j-dunc/Mini-Stylophone-V2/docs/images/render_front.png

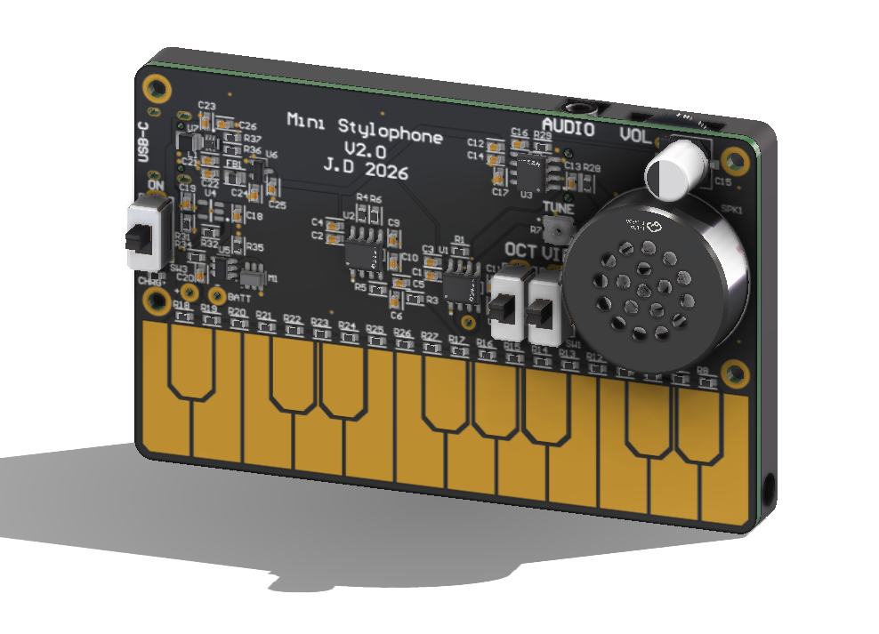
docs/images/render_front.png
