j-dunc/Mini-Stylophone-V2/mechanical/solidworks/top_decal.png

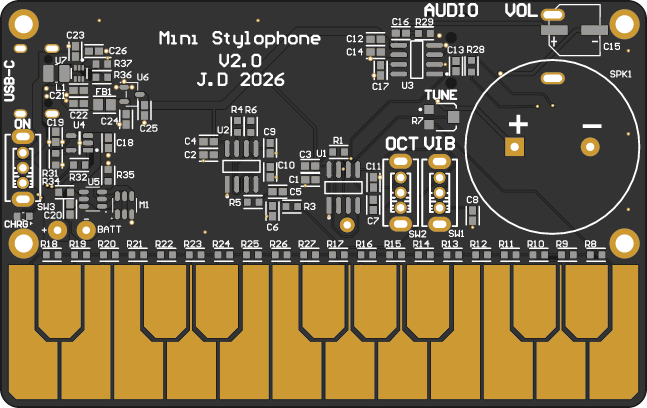
mechanical/solidworks/top_decal.png
