j-dunc/Mini-Stylophone-V2/mechanical/solidworks/StylophonePCB.step

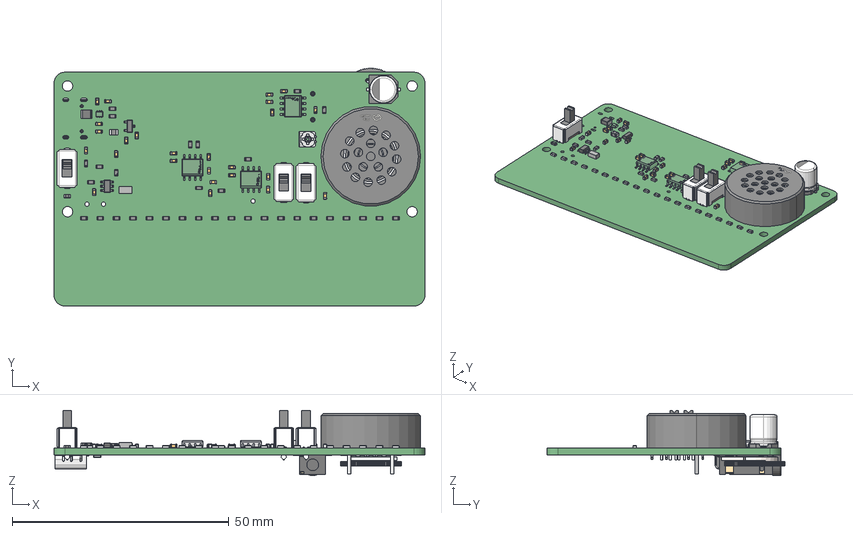
[picture p5: CAD file, 2026-10-17]
mechanical/solidworks/StylophonePCB.step
85.6 x 54.9 x 15.1 mm
USB-C_SMD-TYPE-C-31-M-12_1
name x 25
FRAME-DRL0006A
BODY-SOT
circle x 4
Texas Instruments x 4
Leader x 9
IC_BODY x 3
IC_LEG x 12
IC_LEG_MIR8 x 12
SW-TH_SS12D07VG4 x 3
SPK-TH_BD23.0-P10.00-D0.8-L-RD
Yageo Logo x 35
BOUR-TC33X-2_2
Extruded
Terminal x 2
Mid Body x 2
Electrodes
Dielectric
Murata
CAP-SMD_BD6.3-L6.6-W6.6-FD
RES-SMD_RK10J12R0A0B
AUDIO-SMD_PJ-327A5JJ
