j-dunc/Mini-Stylophone-V2/mechanical/step/Stylus_V1.1.STEP

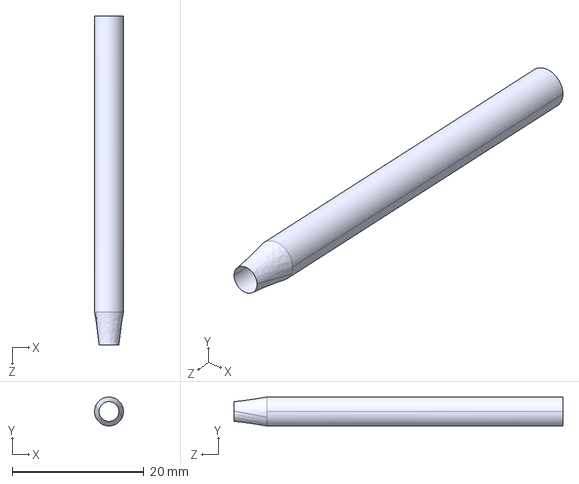
[picture p6: CAD file, 2026-10-17]
mechanical/step/Stylus_V1.1.STEP
4.40 x 4.40 x 50.0 mm
