j-dunc/Mini-Stylophone-V2/mechanical/step/Stylophone_Base_V1.1.STEP

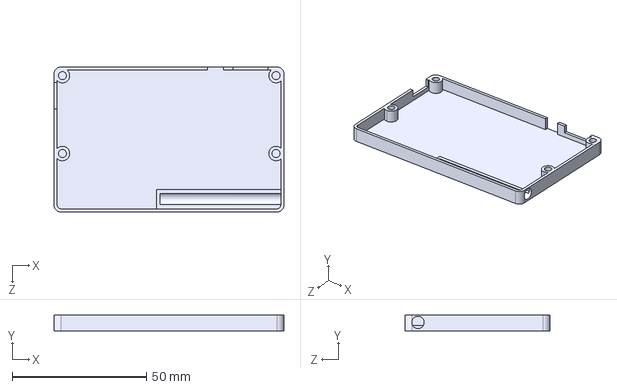
[picture p7: CAD file, 2026-10-17]
mechanical/step/Stylophone_Base_V1.1.STEP
85.6 x 5.80 x 54.0 mm
