j-dunc/Mini-Stylophone-V2/(list of files, cad)

Other CAD files:
mechanical/solidworks/Stylus.SLDPRT
mechanical/solidworks/Stylophone_Base.SLDPRT
mechanical/solidworks/StylophonePCB.SLDASM
