j-dunc/Mini-Stylophone-V2/docs/schematics.pdf

Tone Generator | Vibrato

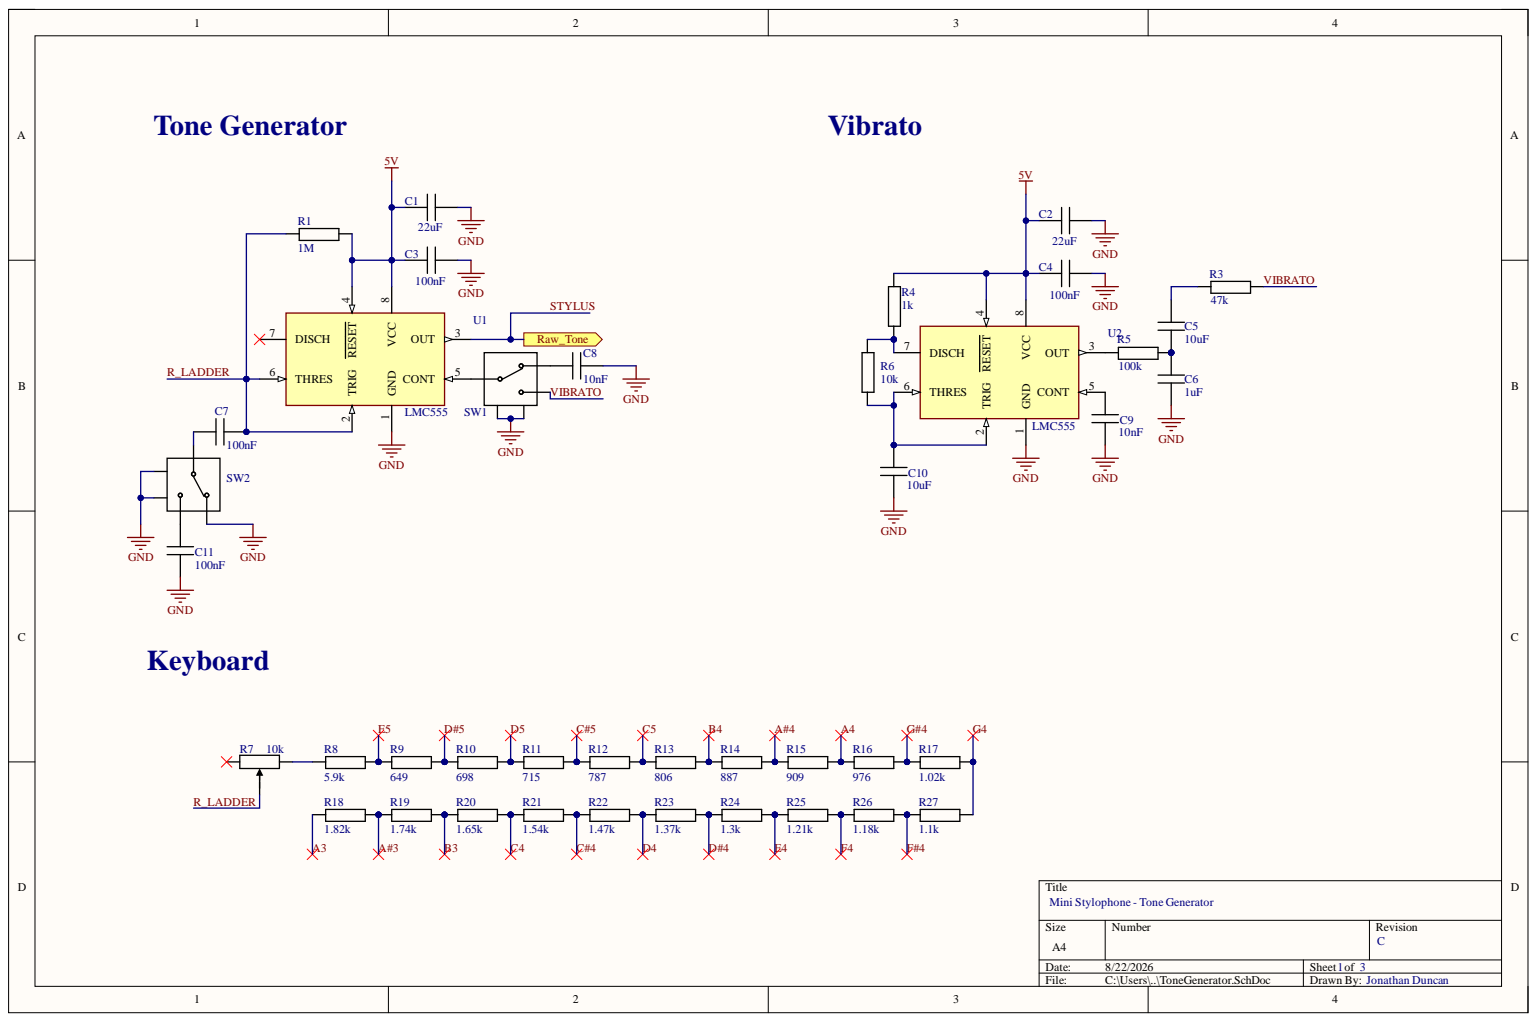
[picture p8: page 1]

Title
Mini Stylophone - Tone Generator

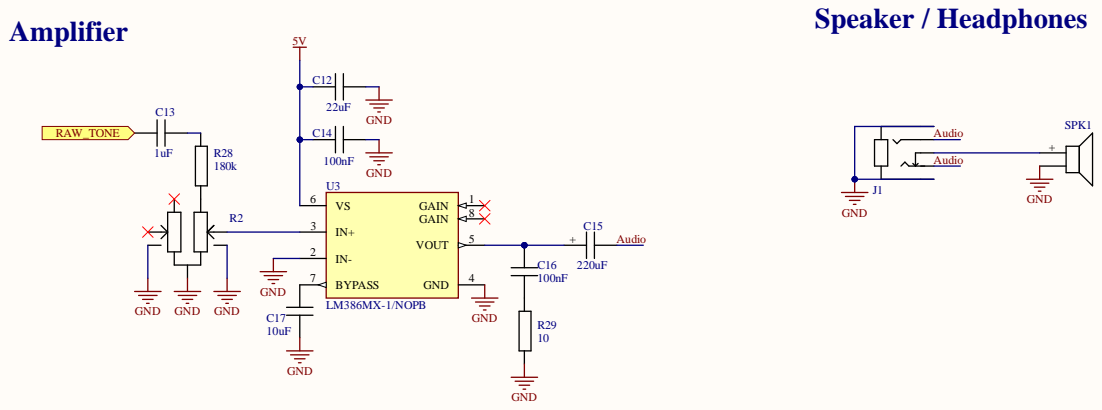
[picture p9: page 2]
Size; umb; Rev; Dat; Sheet; sers; Amp; ifier.Sc; Draw; AIN; SPK; ifier an; d Speaker; nat; han; RAW; Amplifie r

Speaker / Headphones Audio Audio GND R2

# USB C

# Battery Charging

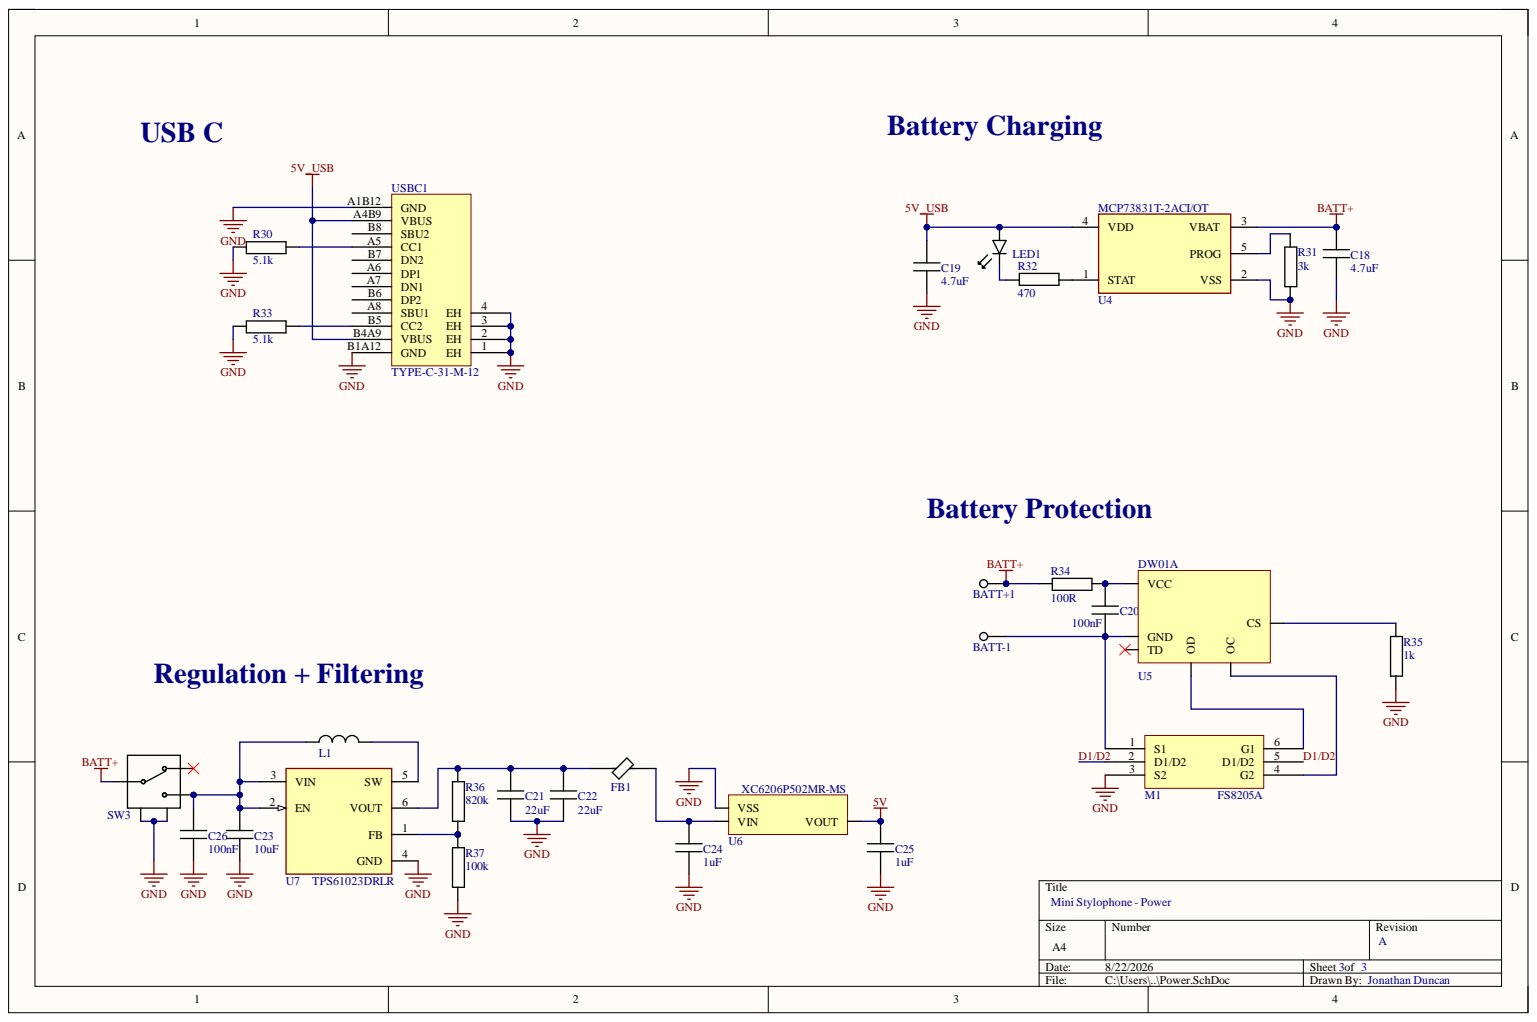
[picture p10: page 3]
