j-dunc/Mini-Stylophone-V2/(list of files, drawings)

Other design files:
hardware/altium/Amplifier.SchDoc
hardware/altium/Mini-Stylophone.PrjPcb
hardware/altium/Power.SchDoc
hardware/altium/StylophonePCB.PcbDoc
hardware/altium/ToneGenerator.SchDoc
