j-dunc/Mini-Stylophone-V2/(commit log)

2026-10-17 Add design files and images
    [Amplifier.SchDoc, Mini-Stylophone-BOM.xlsx, Mini-Stylophone.PrjPcb, Power.SchDoc, StylophonePCB.PcbDoc, StylophonePCB.SLDASM, StylophonePCB.step, Stylophone_Base.SLDPRT]
2026-10-17 Remove outdated BOM
    [Mini-Stylophone-BOM.xlsx]
